charlesh97/hab/docs/superpowers/specs/dashboard.html

# ⦿ HAB-1 STRATOS

ID: #521514 COORDS: 39.3187°N / -120.3289°W

expand_less ASCENT

NOMINAL

GPS LOCK

Last pkt: 1.2s

T+03:14:22

hexagon

menu_open

LIVE MAP v2.4-STABLE

39.3187°N -120.3289°W | Alt: 18,342m

POSITION DATA

SATS

14 3D FIX

HDOP / VDOP

0.82 / 1.34

AGL (ALTITUDE)

17,210m

MOTION

GROUND SPEED 13.8 m/s

VERT SPEED 5.4 ▲ m/s

HEADING 72.6°

COURSE 74.1°

ENVIRONMENT

EXT TEMP

-42.6°C

PRESSURE

72.8 hPa

INT TEMP

12.4°C

HUMIDITY

4.2%

videocam_off NO VIDEO SIGNAL

LIVE

2.4 Mbps 98%

rtsp://192.168.1.100/stream1

RECONNECT

RF LINK STATUS

TLM

PKT

VID

FREQ

915 MHz

SNR

12.3 dB

POWER SYSTEMS

7.62V 0.84A

68%

3.3V: 3.29V

5.0V: 5.01V

12V: 11.9V

SYSTEM ALERTS

No active alerts...

Last packet: 1.2s ago

Link margin: 11 dB

PACKET RATE

2.4 pkt/s

SEQUENCE

#18430

PACKET STREAM RX: 2.4 PKT/S | SEQ: 18430

pause PAUSE delete CLEAR

04:22:31 POS lat: 39.31874, lon: -120.32891, alt_m: 18342.1, sats: 14, fix: 3

04:22:31 MOT gx: 0.02, gy: -0.01, gz: 9.81, ax: 0.1, ay: 0.2, az: -0.1, head: 72.6

04:22:30 ENV temp_ext: -42.61, temp_int: 12.42, press: 72.84, hum: 4.2, baro_alt: 18190

04:22:30 PWR v_batt: 7.62, i_batt: 0.84, p_batt: 6.4, soc: 68

04:22:29 POS lat: 39.31872, lon: -120.32890, alt_m: 18338.5, sats: 14, fix: 3

04:22:29 MOT gx: 0.01, gy: 0.00, gz: 9.79, ax: 0.2, ay: 0.1, az: -0.2, head: 72.5

04:22:28 POS lat: 39.31870, lon: -120.32888, alt_m: 18335.2, sats: 13, fix: 3

04:22:28 SYS RF link degradation detected. SNR dropped to 9.2dB temporarily.

04:22:27 POS lat: 39.31868, lon: -120.32886, alt_m: 18332.0, sats: 13, fix: 3

04:22:27 ENV temp_ext: -42.58, temp_int: 12.40, press: 72.91, hum: 4.1, baro_alt: 18182

FLIGHT OPERATIONS SYSTEM v4.2 SYSTEM HEALTH: NOMINAL UPTIME: 03:14:22

HAB-1

menu_open

⦿ HAB-1 STRATOS

ID: #521514 location_on 45.4215° N, 75.6972° W

● PHASE: ASCENT

NOMINAL

gps_fixed T+03:14:22

notifications settings

# SETTINGS

close

## ═══════ TAB 1: DEVICE ═══════

### Device Discovery

RESCAN

memory

HackRF One [0000000000000000a6e060dc264e6746]

USB BUS 001 ADDR 004

CONNECT

memory

RTLSDR-V3 [Generic 2832U]

USB BUS 001 ADDR 005

BUSY

### Connected Device

CENTER FREQUENCY

915.000 MHz

SAMPLE RATE

2.000 Msps

LNA GAIN

16 dB

VGA GAIN

24 dB

DISCONNECT DEVICE

## ═══════ TAB 2: RF PARAMETERS ═══════

FREQUENCY (MHz)

SYMBOL RATE (Msps)

LO OFFSET (PPM)

LNA GAIN (0-40 dB) 16 dB

VGA GAIN (0-62 dB) 24 dB

AMP ENABLE

DISABLED ENABLED

RESET APPLY PARAMETERS

## ═══════ TAB 3: DVB-S2 ═══════

MODCOD

PILOTS

ROLLOFF

FEC FRAME

SPS

DEVICE ARGUMENTS (ADVANCED)

RRC DELAY 10 taps

SINK TYPE TCP SERVER :5000

## ═══════ TAB 4: PIPELINE ═══════

/opt/stratos/capture/telemetry_915mhz.ts BROWSE

play_arrow START PIPELINE stop STOP

BITRATE

965,326 bps

DURATION

00:47:32

DROP RATIO

0.02%

SINK HEALTH

ACTIVE

FFMPEG_STREAM_OUT

[h264 @ 0x559e86c] frame=1240 fps=30 q=28.0 size=450kB time=00:00:41.33 bitrate=89.2kbits/s speed=1x
[h264 @ 0x559e86c] frame=1270 fps=30 q=28.0 size=482kB time=00:00:42.33 bitrate=93.4kbits/s speed=1x
[h264 @ 0x559e86c] frame=1300 fps=30 q=29.0 size=512kB time=00:00:43.33 bitrate=96.7kbits/s speed=1x

TSP_PACKET_PROCESSOR

* tsp: PID 0x0100 (SDT) pkt: 4,502, rate: 1,200 b/s
* tsp: PID 0x1FFF (Null) pkt: 1,204,502, rate: 45,600 b/s
* tsp: PID 0x0010 (NIT) pkt: 890, rate: 200 b/s

## ═══════ TAB 5: ABOUT ═══════

### System Status

SYSTEM UPTIME 72h 14m 05s

WEBSOCKET STATUS CONNECTED

CORE LOAD 12.4%

DISK USAGE (CAPTURE) 244 GB / 1024 GB

### Software Build

STRATOS v0.5-dev

HASH: 7a8c3d1f_main_stable

BUILD: 2023-11-20T14:42:00Z

CHECK FOR UPDATES

list_alt EVENT LOG

[14:42:01] HackRF One #...67464 connected. [14:42:05] Sink stream initialized on :5000 [14:42:10] Adjusting LNA Gain to +16dB (Auto)

terminal PACKET STREAM

PAUSE CLEAR EXPORT CSV

[14:42:12.4] 0x00FF2A01 FF 00 FF AA 32 1C 44 91 00 22 AB 99 FD 01 00 00 44 EF ...

[14:42:12.5] 0x00FF2A02 FF 00 FF AA 32 1C 44 91 00 22 AB 99 FD 01 00 00 45 FF ...

[14:42:12.6] 0x00FF2A03 FF 00 FF AA 32 1C 44 91 00 22 AB 99 FD 01 00 00 46 A1 ...

[14:42:12.7] 0x00FF2A04 FF 00 FF AA 32 1C 44 91 00 22 AB 99 FD 01 00 00 47 B2 ...

[14:42:12.8] 0x00FF2A05 FF 00 FF AA 32 1C 44 91 00 22 AB 99 FD 01 00 00 48 C3 ...

[14:42:12.9] 0x00FF2A06 FF 00 FF AA 32 1C 44 91 00 22 AB 99 FD 01 00 00 49 D4 ...

[14:42:13.0] 0x00FF2A07 FF 00 FF AA 32 1C 44 91 00 22 AB 99 FD 01 00 00 50 E5 ...

FLIGHT OPERATIONS SYSTEM v4.2

TELEMETRY LOG SYSTEM HEALTH MANUAL OVERRIDE
