charlesh97/hab/.superpowers/brainstorm/64589-1780717157/content/layout-proposal.html

## Proposed Layout: Map-Left / Video-Center / Data-Right

All data cards consolidated on the right — is this the direction you're thinking?

Current Layout (scattered cards)

Map

[Leaflet]

Position

Lat/Lon/Alt/Sats

Motion

GS/VS/Heading/Yaw

Environment

Temp/Pres/Humidity

Camera Feed

No video

RF Link

TEL/PKT/VID status

Power

Battery/Voltage

Alerts

Packet Rate

Proposed: Map | Video | Data Cards

HAB-1 STRATOS NOMINAL | T+03:45:12

Live Map

Leaflet Map
+ balloon track

Video Feed

Stream / Placeholder

Navigation

ALT 24,348m

GS 9.4m/s

VS +4.2m/s

HDG 045°

LAT 34.1234°N

LON 118.5678°W

SATS 11

HDOP 1.2

Environment

EXT -52.3°C

INT +22.1°C

PRESS 68.5hPa

HUM 12%

Power & Link

BAT 88.5% 12.1V / 0.8A

TEL PKT VID 12.4pkt/s

Attitude

ROLL 2.3°

PITCH -1.5°

YAW 045°

> Packet Stream

[14:10:23] POS lat=34.1234 lon=-118.5678 alt=24348 sats=11

[14:10:22] ENV ext=-52.3 int=22.1 pres=68.5 hum=12

### Right column: grouping approach

How should the consolidated data cards be organized on the right?

A

### Grouped by category (shown above)

Navigation, Environment, Power & Link, Attitude — each gets its own card

B

### Single unified telemetry card

One tall card with labeled sections — Navigation, Environment, Power, Attitude
