charlesh97/hab/docs/analysis/nmea.md

# Exhaustive Line-by-Line Analysis of `nmea.py`

**File:** `payload/gps/nmea.py` (180 lines)
**Context:** HAB (High-Altitude Balloon) packet radio — GPS-to-BPSK pipeline
**Hardware:** Quectel L76K GNSS module → Radxa Rock 2A UART0 (pins 8/10) at 9600 baud 8N1
**Used by:** `payload/tx/gps_packet_tx.py` (main TX loop), `payload/tests/test_gps.py` (Phase 1D validation)

---

## Table of Contents

1. [Module Docstring & Imports (Lines 1–6)](#1-module-docstring--imports-lines-16)
2. [Module-Level Constants (Lines 8–9)](#2-module-level-constants-lines-89)
3. [`nmea_checksum_ok()` — Checksum Validation (Lines 12–31)](#3-nmea_checksum_ok--checksum-validation-lines-1231)
4. [`_safe_float()` — Robust Float Parsing (Lines 34–40)](#4-_safe_float--robust-float-parsing-lines-3440)
5. [`_nmea_dm_to_dd()` — Coordinate Conversion (Lines 43–68)](#5-_nmea_dm_to_dd--coordinate-conversion-lines-4368)
6. [`parse_gga()` — GGA Sentence Parser (Lines 71–102)](#6-parse_gga--gga-sentence-parser-lines-71102)
7. [`parse_rmc()` — RMC Sentence Parser (Lines 105–134)](#7-parse_rmc--rmc-sentence-parser-lines-105134)
8. [`NMEAParser` Class (Lines 137–180)](#8-nmeaparser-class-lines-137180)
9. [Hardware Integration: L76K on Rock 2A](#9-hardware-integration-l76k-on-rock-2a)
10. [Usage in the Pipeline](#10-usage-in-the-pipeline)
11. [Error Handling & Robustness Summary](#11-error-handling--robustness-summary)
12. [Design Observations & Tradeoffs](#12-design-observations--tradeoffs)

---

## 1. Module Docstring & Imports (Lines 1–6)

### Line 1
```python
"""GPS NMEA parser using a 9600-baud 8N1 serial connection."""
```
The module docstring. Concise but precise: it names the protocol (NMEA), the physical layer (serial), the bit rate (9600 baud), and the framing (8 data bits, No parity, 1 stop bit — 8N1). This is not aspirational — it's the exact configuration the L76K ships with by default.

### Line 3
```python
from __future__ import annotations
```
Enables PEP 563 / PEP 604 `X | Y` union syntax without runtime cost. Available from Python 3.7+. Placed at the top of the file after the docstring, before any other imports, as required. This allows the module to use `str | None`, `float | None`, `dict[str, object] | None` in type hints without importing `Optional` or `Union` from `typing`.

### Line 5
```python
import serial
```
Single external dependency: `pyserial`. This is a pure-Python library that wraps OS-level serial port access (`/dev/ttyS0`, `/dev/ttyAMA0`, etc. on Linux; `COM` ports on Windows). On line 5, there is no try/except guard — the import is assumed to succeed. The TX pipeline and test scripts handle the `ImportError` at their own level. Given the target platform (Radxa Rock 2A running Armbian Debian 13), `pyserial` is installed via `apt` or `pip`.

---

## 2. Module-Level Constants (Lines 8–9)

### Line 8
```python
GPS_BAUD = 9600
```
The serial baud rate. 9600 is the L76K's factory default communication speed. This is intentionally low — GPS modules output at most a few dozen NMEA sentences per second, each under 100 bytes, so 9600 baud (~960 chars/sec) is more than sufficient. Higher baud rates (115200) are available on the L76K but would require explicit AT command configuration. 9600 baud was chosen because it's the module's power-on default — no init dance needed; just open the port.

### Line 9
```python
GPS_TIMEOUT = 1.0
```
Serial read timeout in seconds. Passed to `serial.Serial(timeout=...)`. With a 1-second timeout, `readline()` will block for at most 1 second waiting for a newline character. If no complete line arrives within that window, `readline()` returns whatever partial data has been buffered (or an empty bytes object if nothing was received at all). This is a critical design choice:

- **Too short** (e.g., 0.1s): risk of truncating valid NMEA sentences mid-stream, especially on a busy bus with GSV sentences arriving in bursts.
- **Too long** (e.g., 5s): the TX loop in `gps_packet_tx.py` runs at 1 Hz — a 5-second timeout would stall the loop and miss transmission windows if GPS data stops.
- **1.0s** is the sweet spot: it's a full GPS epoch (most modules output position fixes at 1 Hz), so if no data arrives in 1 second, something is wrong.

---

## 3. `nmea_checksum_ok()` — Checksum Validation (Lines 12–31)

### Line 12
```python
def nmea_checksum_ok(sentence: str) -> bool:
```
Module-level function (not inside the class). Takes a raw NMEA sentence string and returns `True` only if the checksum validates. The NMEA 0183 standard specifies that each sentence ends with `*HH` where `HH` is the two-character hexadecimal XOR checksum of all bytes between (but not including) `$` and `*`. The type hint `str -> bool` is simple and honest.

### Line 13
```python
    """Validate the XOR checksum of an NMEA sentence."""
```
Docstring. Brief but accurate. Does not mention the return type or edge cases — the code is self-documenting.

### Line 14–17
```python
    try:
        payload, checksum_str = sentence.split("*")
    except (AttributeError, ValueError):
        return False
```
The first computational block. `split("*")` on a string with no `*` raises `ValueError` (too few values to unpack). `AttributeError` is caught because `sentence` could theoretically be `None` (calling `.split()` on `None` raises `AttributeError`), though in practice callers don't pass `None`. Both exceptions return `False` — the sentence is considered invalid. This is a fail-closed approach: any structural anomaly means "not valid."

**`payload`** gets everything before the asterisk (e.g., `$GPGGA,123519,4807.038,N,01131.000,E,1,08,0.9,545.4,M,46.9,M,,`).
**`checksum_str`** gets everything after the asterisk (e.g., `47`). Note that `checksum_str` may include trailing whitespace or Carriage Return — that's handled at line 27.

### Line 19–20
```python
    if not payload.startswith("$"):
        return False
```
Guard: if the part before `*` doesn't start with `$`, it's not a proper NMEA sentence. This catches garbage lines, binary noise, or malformed data. Example of what fails: `GPGGA,120000,...*1A` (missing `$`).

### Lines 22–24
```python
    computed = 0
    for char in payload[1:]:
        computed ^= ord(char)
```
The core XOR checksum computation. The NMEA standard says: "The checksum is the 8-bit exclusive OR (no start or stop bits) of all characters in the sentence, including `,` delimiters, between but not including `$` and `*`."

- `computed = 0` initializes the accumulator.
- `payload[1:]` skips the leading `$` — this is crucial. Including `$` in the XOR would produce a wrong checksum.
- `ord(char)` converts each character to its ASCII byte value (0–127).
- `^=`: XOR-accumulation. `0 ^ X = X`, and each subsequent byte XORs with the running total.

For `$GPGGA,123519,...*47`:
- Payload after `$`: `GPGGA,123519,...`
- `computed = ord('G') ^ ord('P') ^ ord('G') ^ ord('G') ^ ord('A') ^ ord(',') ^ ...`

### Lines 26–29
```python
    try:
        expected = int(checksum_str.strip(), 16)
    except ValueError:
        return False
```
Parses the expected checksum from the string after `*`. `strip()` removes whitespace and trailing `\r` (carriage return, common in NMEA serial output). `int(..., 16)` parses hex: `"47"` → `0x47` (71 decimal). If `checksum_str` is not valid hex (e.g., `"ZZ"`, or empty), `ValueError` is caught and returns `False`.

### Line 31
```python
    return computed == expected
```
The final comparison. Returns `True` only if the XOR of the payload bytes matches the declared hex checksum. This is the gatekeeper: only sentences with valid checksums pass. In the HAB pipeline, a corrupted checksum means the sentence was damaged in transit over the UART connection (unlikely but possible with long wires or EMI) and the data is discarded — better to lose one fix than transmit bad coordinates.

---

## 4. `_safe_float()` — Robust Float Parsing (Lines 34–40)

### Line 34
```python
def _safe_float(value: str) -> float | None:
```
The leading underscore marks this as a module-internal helper. Takes a string (an NMEA field) and returns either a `float` or `None`. The return type `float | None` uses the PEP 604 union syntax.

### Lines 35–36
```python
    if not value or not value.strip():
        return None
```
Two-part guard:
- `not value`: catches `""` (empty string, which is falsy) and potentially `None` (though the type hint says `str`).
- `not value.strip()`: catches fields that are only whitespace, e.g., `"   "` or `"\r"`.

In NMEA, empty fields are common: for example, `$GPGGA,...*47,,,` has two adjacent commas, meaning the field between them is empty. Some receivers also output fields like `,,` for altitude when no fix is available. Return `None` for any of these cases — no attempt to parse as float.

### Lines 37–38
```python
    try:
        return float(value)
```
Attempts to parse the string as a float. Python's `float()` handles both integer-looking strings (`"08"` → `8.0`) and decimal strings (`"0.9"` → `0.9`). Strips leading/trailing whitespace automatically, but the guard above already handled blank fields.

### Lines 39–40
```python
    except ValueError:
        return None
```
Catches any non-numeric string (e.g., `"N/A"`, `"invalid"`, or corrupted binary garbage). Returns `None` — the caller must handle missing data.

---

## 5. `_nmea_dm_to_dd()` — Coordinate Conversion (Lines 43–68)

### Line 43
```python
def _nmea_dm_to_dd(raw: str, hemisphere: str) -> float | None:
```
Converts NMEA's Degrees-Minutes format (DDMM.MMMM or DDDMM.MMMM) to decimal degrees. Takes two arguments:
- `raw`: the coordinate string from the NMEA field (e.g., `"4807.038"` for 48°07.038', or `"01131.000"` for 11°31.000').
- `hemisphere`: `"N"`, `"S"`, `"E"`, or `"W"`. Determines sign.

Returns `float` (decimal degrees, rounded to 6 decimal places) or `None` on parse failure.

### Lines 45–46
```python
    if not raw or not hemisphere:
        return None
```
Guard: both arguments must be non-empty. If either is empty, the coordinate is meaningless.

### Lines 48–52
```python
    try:
        if "." in raw:
            int_part, frac_part = raw.split(".", 1)
        else:
            int_part, frac_part = raw, "0"
```
Splits the raw coordinate at the decimal point into integer and fractional parts. The `1` argument to `split` limits to one split — important if there were somehow multiple dots (though that shouldn't happen with valid NMEA). If there's no decimal point (unlikely in practice), treats the entire string as integer part and `"0"` as fractional.

Example: `"4807.038"` → `int_part="4807"`, `frac_part="038"`

The `try` wraps the entire function body — any `ValueError` or `IndexError` from any operation returns `None`.

### Lines 54–57
```python
        if len(int_part) <= 4:
            degree_length = 2
        else:
            degree_length = 3 if hemisphere in ("E", "W") else 2
```
This is the most subtly important logic in the file: determining how many digits represent degrees vs. minutes.

**Latitude (N/S):** Always 2 digits for degrees (max 90°). So `"4807.038"` → 2 degree digits + minutes.

**Longitude (E/W):** Either 2 or 3 digits (max 180°). The ambiguity arises because raw longitude can be `"01131.000"` (3 digits for 11°) or `"12045.678"` (3 digits for 120°). The heuristic:
- If `len(int_part) <= 4`: the total integer portion is short. If it's 4 digits like `"4807"`, that's 2 degree digits. If it's 5 digits like `"01131"`, that's 3 degree digits. But at this branch `len(int_part) <= 4`, so only ever 2 degree digits.
- If `len(int_part) > 4` (i.e., 5 digits like `"12045"` for 120°45'): degree_length is 3 for E/W (longitude can be up to 180°), 2 for N/S (latitude never exceeds 90°, so 5 digits would mean 2 degree digits + 3-minute integer digits for latitudes near the poles).

This logic is a simplified version of the test script's approach. It handles all valid NMEA coordinates but could theoretically misparse a 5-digit latitude if one were received (should never happen — latitudes are max ~90°, so the integer part is at most 2 digits for degrees, making the total integer part at most 4 digits: `"90"` + `"00"` = `"9000"`).

### Lines 59–61
```python
        degrees = float(int_part[:degree_length])
        minutes = float(int_part[degree_length:] + "." + frac_part)
        decimal_degrees = degrees + minutes / 60.0
```
The actual conversion:
- `int_part[:degree_length]` extracts the degree digits. For `"4807"` with `degree_length=2`: `"48"` → 48.0°.
- `int_part[degree_length:]` extracts the minute integer portion: `"07"`.
- `+ "." + frac_part` reconstructs the fractional minutes: `"07"` + `"."` + `"038"` → `"07.038"` → 7.038 minutes.
- `degrees + minutes / 60.0`: 48.0 + 7.038/60 = 48.0 + 0.1173 = 48.1173.

### Lines 63–64
```python
        if hemisphere in ("S", "W"):
            decimal_degrees = -decimal_degrees
```
Southern latitudes and western longitudes are negative. Northern latitudes and eastern longitudes are positive. This follows standard convention (WGS84).

### Line 66
```python
        return round(decimal_degrees, 6)
```
Rounds to 6 decimal places. At the equator, 0.000001° ≈ 0.111 meters. This is far more precision than the L76K's stated accuracy (2.5m CEP), so no meaningful precision is lost. Rounding also avoids floating-point display artifacts (e.g., `48.117300000000004`).

### Lines 67–68
```python
    except (ValueError, IndexError):
        return None
```
Catch-all for any parsing failure within the try block. Returns `None` — the caller (`parse_gga` or `parse_rmc`) propagates `None` to the result dict.

---

## 6. `parse_gga()` — GGA Sentence Parser (Lines 71–102)

### Line 71
```python
def parse_gga(sentence: str) -> dict[str, object] | None:
```
Module-level function. Takes a raw NMEA GGA sentence string. Returns a dictionary with parsed fields, or `None` if the sentence is invalid. The `object` type in the return annotation is a pragmatic choice — the dict contains `str`, `float`, `int`, and `None` values at runtime. Returns `None` for any sentence that is structurally invalid, has invalid checksum, is not a GGA sentence, or is missing critical fields.

### GGA Sentence Format (reference)

```
$GPGGA,123519.00,4807.038,N,01131.000,E,1,08,0.9,545.4,M,46.9,M,,*47
|      |         |         | |         | | |  |   |     | |     | |  |
0      1         2         3 4         5 6 7  8   9     10 11   12 13 14
```

| Field Index | Name | Example | Description |
|---|---|---|---|
| 0 | Talker+ID | $GPGGA | Sentence identifier |
| 1 | UTC Time | 123519.00 | HHMMSS.SS UTC |
| 2 | Latitude | 4807.038 | DDMM.MMMM |
| 3 | N/S indicator  | N | 'N' or 'S' |
| 4 | Longitude | 01131.000 | DDDMM.MMMM |
| 5 | E/W indicator  | E | 'E' or 'W' |
| 6 | Fix Quality | 1 | 0=invalid, 1=GPS fix, 2=DGPS, 6=DR |
| 7 | Satellites | 08 | Number of satellites used |
| 8 | HDOP | 0.9 | Horizontal dilution of precision |
| 9 | Altitude | 545.4 | Altitude above MSL (meters) |
| 10 | Altitude units | M | 'M' for meters |
| 11 | Geoid height | 46.9 | Height of geoid above WGS84 ellipsoid |
| 12 | Geoid units | M | 'M' for meters |
| 13 | DGPS age | (empty) | Time since last DGPS update |
| 14 | DGPS station | (empty) | DGPS reference station ID |

### Line 73
```python
    sentence = sentence.strip()
```
Strips leading and trailing whitespace (including `\r\n`). NMEA sentences from serial ports typically arrive as `$GPGGA,...*47\r\n`. The `\r\n` must be removed before checksum validation, since the checksum computation does not include `\r` or `\n`.

### Lines 74–75
```python
    if not nmea_checksum_ok(sentence):
        return None
```
Checksum validation is the first gate. If the checksum doesn't match, the sentence is discarded immediately — no parsing of fields.

### Lines 77–79
```python
    fields = sentence.split(",")
    if len(fields) < 11 or not fields[0].lstrip("$").endswith("GGA"):
        return None
```
Two checks:
1. **`len(fields) < 11`**: A valid GGA sentence has at least 11 comma-separated fields (indices 0–10). Fields 11–14 are optional. This check ensures we have enough fields to extract time, position, fix quality, satellites, HDOP, and altitude.
2. **`fields[0].lstrip("$").endswith("GGA")`**: The first field must identify as a GGA sentence. `lstrip("$")` removes the leading `$`, then `endswith("GGA")` matches any talker prefix: `GPGGA` (GPS), `GLGGA` (GLONASS), `GNGGA` (multi-constellation), `BDGGA` (BeiDou). The L76K is a multi-GNSS receiver and will output sentences with different talker IDs depending on which constellations are active.

### Lines 81–89 — Field Extraction

```python
    utc_time = fields[1]
    lat_raw = fields[2]
    lat_ns = fields[3]
    lon_raw = fields[4]
    lon_ew = fields[5]
    fix_quality = _safe_float(fields[6])
    satellites = _safe_float(fields[7])
    altitude = _safe_float(fields[9])
    hdop = _safe_float(fields[8])
```

Each field is extracted by positional index:

- **`utc_time` (field 1):** Raw UTC time string, e.g., `"123519.00"` for 12:35:19.00 UTC. Stored as-is; no parsing to datetime object.
- **`lat_raw` (field 2):** Raw latitude in DDMM.MMMM format, e.g., `"4807.038"`.
- **`lat_ns` (field 3):** Hemisphere for latitude — `"N"` or `"S"`.
- **`lon_raw` (field 4):** Raw longitude in DDDMM.MMMM format, e.g., `"01131.000"`.
- **`lon_ew` (field 5):** Hemisphere for longitude — `"E"` or `"W"`.
- **`fix_quality` (field 6):** Numeric fix quality indicator, parsed via `_safe_float`. Returns `None` if empty/invalid.
  - 0 = invalid / no fix
  - 1 = GPS fix (SPS)
  - 2 = DGPS fix
  - 4 = RTK fixed (not expected from L76K)
  - 5 = RTK float (not expected from L76K)
  - 6 = Dead reckoning (estimated)
- **`satellites` (field 7):** Number of satellites used in the position solution. `_safe_float` handles empty strings (no fix) → `None`.
- **`altitude` (field 9):** Altitude above Mean Sea Level in meters. Note: field 8 (HDOP) is extracted *after* field 9 — this is intentional: the order in the assignment doesn't matter since each is independent.
- **`hdop` (field 8):** Horizontal Dilution of Precision. A dimensionless number; lower is better. `<1.0` is excellent, `1-2` is good, `>5` is poor. hdop is extracted from field 8 (sandwiched between satellites and altitude) and parsed to `float` or `None`.

Note: altitude units (field 10, `"M"`) and geoid separation (fields 11–12) are not extracted — they're not needed for the PositionFrame.

### Lines 91–92
```python
    if not utc_time or not lat_raw or not lon_raw:
        return None
```
The three critical fields: time, latitude, and longitude. If any is empty or falsy (including `""`), the sentence is discarded. This handles the case where a GGA sentence has valid checksum but represents a "no fix" state with empty position fields. Without this guard, `_nmea_dm_to_dd` would get empty strings.

### Lines 94–102 — Return Dict Construction
```python
    return {
        "time": utc_time,
        "lat": _nmea_dm_to_dd(lat_raw, lat_ns),
        "lon": _nmea_dm_to_dd(lon_raw, lon_ew),
        "fix_quality": int(fix_quality) if fix_quality is not None else None,
        "altitude": altitude,
        "satellites": int(satellites) if satellites is not None else None,
        "hdop": hdop,
    }
```

Key field mappings:

| Dict Key | Source | Notes |
|---|---|---|
| `"time"` | `utc_time` | Raw string, e.g., `"123519.00"`. Not parsed to structured time. |
| `"lat"` | `_nmea_dm_to_dd(lat_raw, lat_ns)` | Decimal degrees, e.g., `48.1173`. `None` if conversion fails. |
| `"lon"` | `_nmea_dm_to_dd(lon_raw, lon_ew)` | Decimal degrees, e.g., `11.516667`. `None` if conversion fails. |
| `"fix_quality"`| `fix_quality` | Converted to `int` (e.g., `float(1.0)` → `int(1)`). `None` if unparseable. |
| `"altitude"` | `altitude` | `float` meters MSL or `None`. |
| `"satellites"` | `satellites`  | Converted to `int`. `None` if unparseable. |
| `"hdop"` | `hdop` | `float` or `None`. |

The `int(fix_quality) if fix_quality is not None else None` pattern ensures that values like `1.0` (parsed by `_safe_float` which returns `float`) become `int` `1` rather than `1.0`. Similarly for `satellites`. This matters for downstream consumers (`gps_packet_tx.py` line 172: `int(fq) if fq is not None else 0`) which expect integer values.

**Important:** The `"altitude"` field is stored as a raw `float` — no `int()` conversion because altitude can legitimately have fractional meters (`545.4`). The TX pipeline assigns this directly to `PositionFrame.alt_m` (a float field).

---

## 7. `parse_rmc()` — RMC Sentence Parser (Lines 105–134)

### Line 105
```python
def parse_rmc(sentence: str) -> dict[str, object] | None:
```
Module-level function for parsing RMC (Recommended Minimum Navigation Information) sentences. RMC provides time, date, position, speed over ground, and track angle. While not currently used in the main TX pipeline (which only calls `parse_gga`), it's included for completeness and is exercised in the test script.

### RMC Sentence Format (reference)

```
$GPRMC,123519,A,4807.038,N,01131.000,E,022.4,084.4,230394,003.1,W*6A
|      |       | |         | |         | |     |     |      |     |
0      1       2 3         4 5         6 7     8     9      10    11
```

| Field Index | Name | Example | Description |
|---|---|---|---|
| 0 | Talker+ID | $GPRMC | Sentence identifier |
| 1 | UTC Time | 123519 | HHMMSS UTC |
| 2 | Status | A | 'A'=valid, 'V'=warning |
| 3 | Latitude | 4807.038 | DDMM.MMMM |
| 4 | N/S indicator  | N | 'N' or 'S' |
| 5 | Longitude | 01131.000 | DDDMM.MMMM |
| 6 | E/W indicator  | E | 'E' or 'W' |
| 7 | Speed (knots)  | 022.4 | Speed over ground |
| 8 | Track angle | 084.4 | Course over ground, degrees true |
| 9 | Date | 230394 | DDMMYY |
| 10 | Mag variation  | 003.1 | Magnetic variation, degrees |
| 11 | Var direction  | W | 'E' or 'W' |

### Lines 107–109
```python
    sentence = sentence.strip()
    if not nmea_checksum_ok(sentence):
        return None
```
Same pattern as `parse_gga`: strip whitespace, validate checksum first.

### Lines 111–113
```python
    fields = sentence.split(",")
    if len(fields) < 10 or not fields[0].lstrip("$").endswith("RMC"):
        return None
```
Minimum 10 fields for RMC (indices 0–9). Matches any talker prefix ending with `RMC`: `GPRMC`, `GLRMC`, `GNRMC`.
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
