charlesh97/hab/soak/2026-07-31_163520/stills/still_0013.jpg

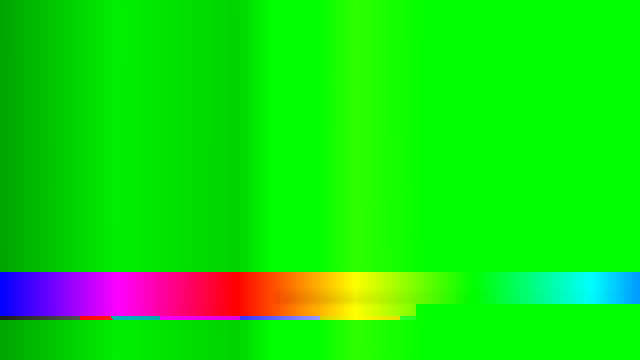
soak/2026-07-31_163520/stills/still_0013.jpg
