charlesh97/hab/hardware/105mmHeater.dxf

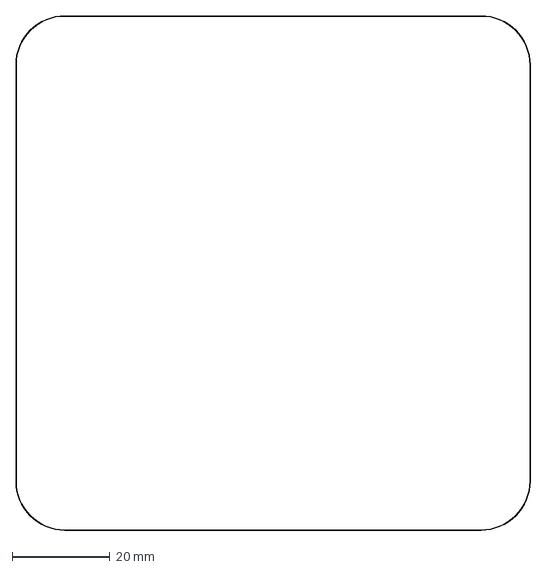
[picture p10: CAD file, 2025-11-26]
hardware/105mmHeater.dxf
105.0 x 105.0 mm
