charlesh97/hab/hardware/hab-devboard/Keepout.dxf

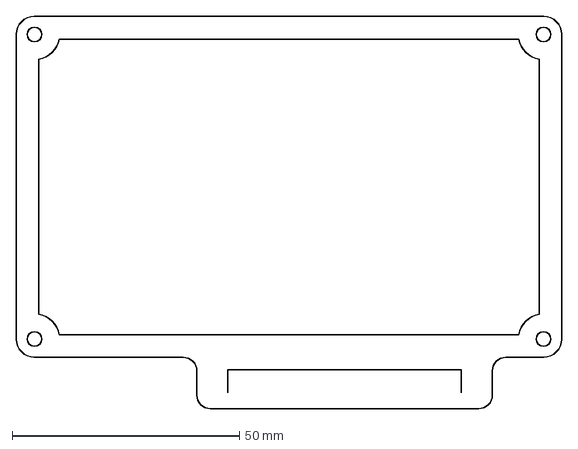
[picture p11: CAD file, 2025-11-16]
hardware/hab-devboard/Keepout.dxf
120.0 x 86.3 mm
