charlesh97/hab/hardware/temperature/output/temperature.step

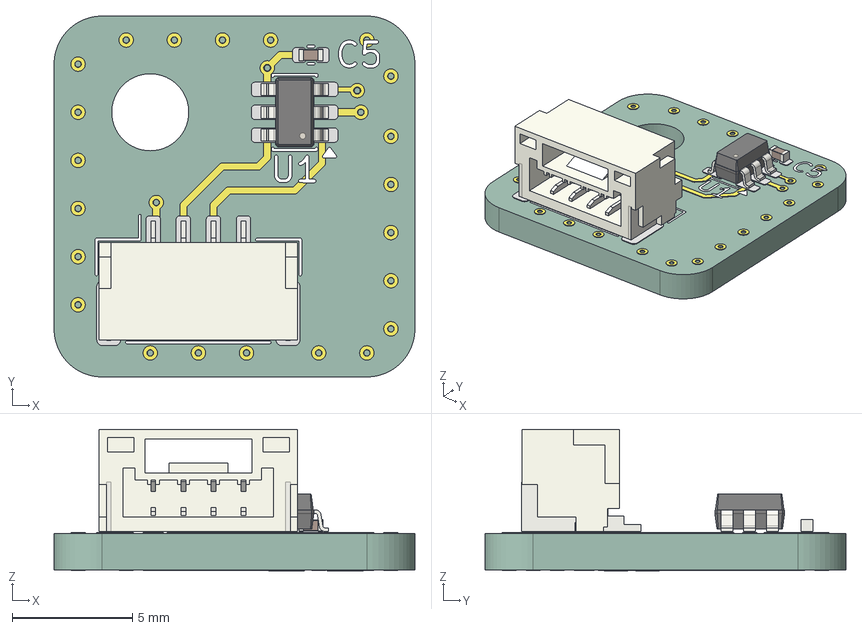
[picture p12: CAD file, 2025-11-26]
hardware/temperature/output/temperature.step
15.0 x 15.0 x 5.92 mm
C_0402_1005Metric
SOT-23-6
JST_GH_SM04B-GHS-TB_1x04-1MP_P1.25mm_Horizontal
temperature_copper
temperature_pad
temperature_via
temperature_silkscreen x 2
temperature_PCB
