charlesh97/hab/hardware/Power_Amplifier.dxf

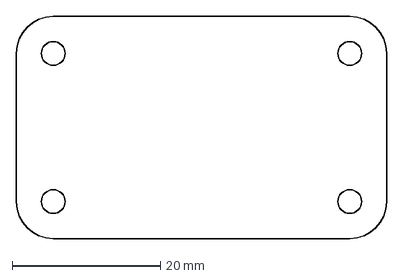
[picture p13: CAD file, 2025-11-16]
hardware/Power_Amplifier.dxf
50.0 x 30.0 mm
