charlesh97/hab/hardware/hab-devboard/output/devboard.pdf

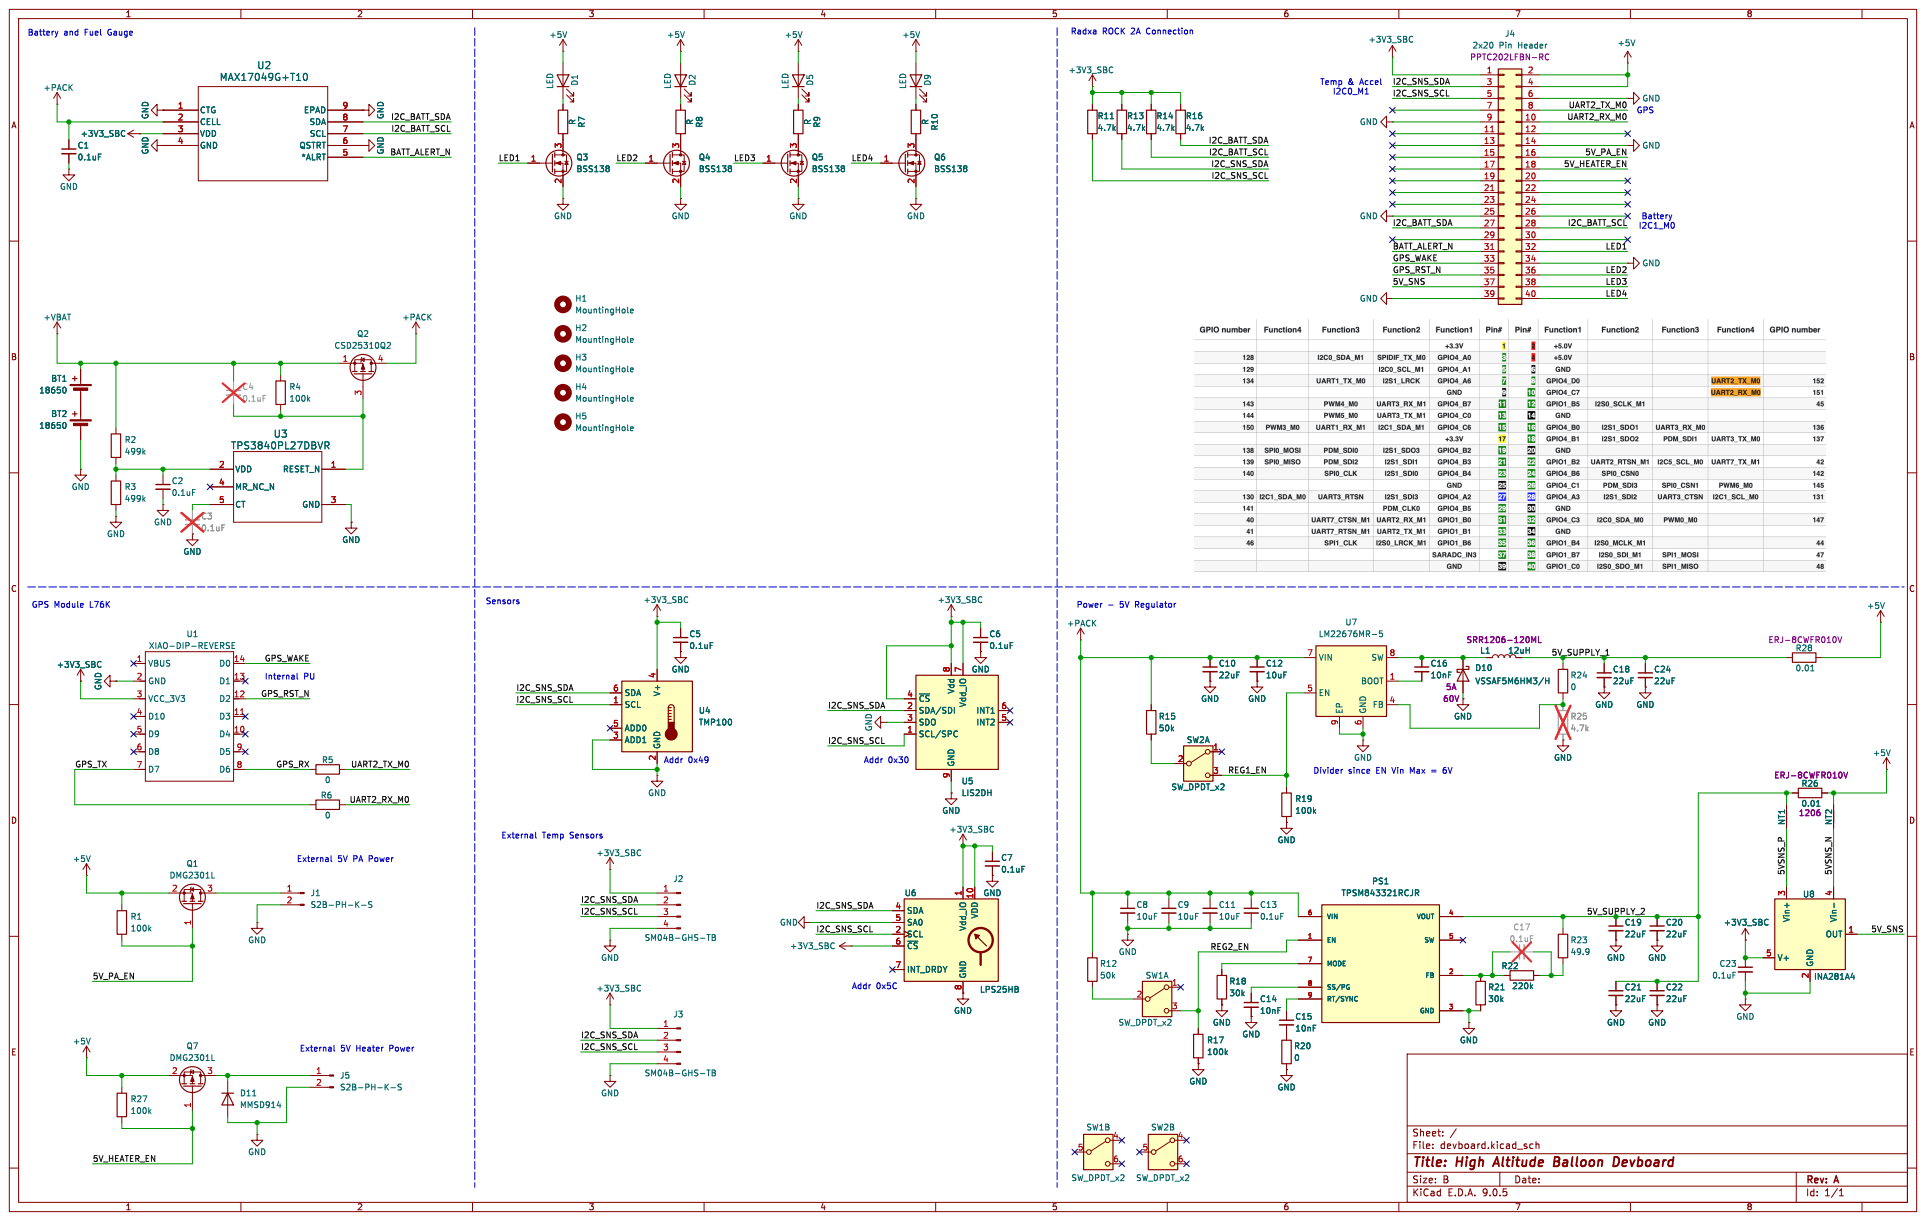
[picture p14: page 1]

H5 MountingHole H1 MountingHole H3 MountingHole H4 MountingHole +PACK

Id: 1/1 Title: High Altitude Balloon Devboard
