charlesh97/hab/hardware/temperature/temperature.kicad_pcb

## KiCad design hardware/temperature/temperature.kicad_pcb (2025-11-26)

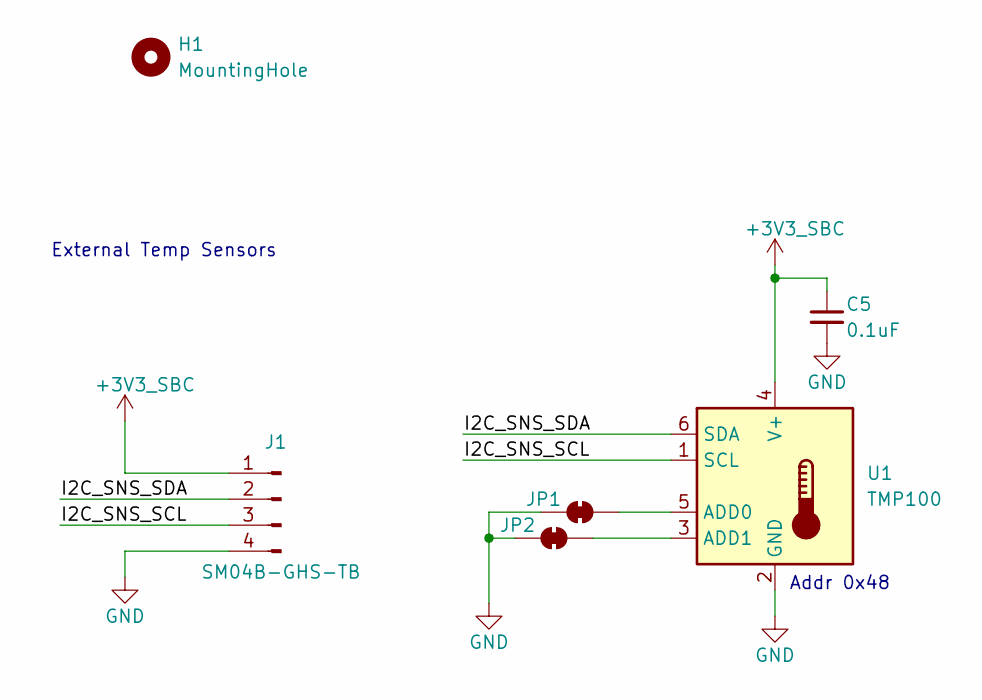
[picture p15: schematic temperature.kicad_sch]

Parts:
C5: 0.1uF; C_0402_1005Metric
H1: MountingHole; MountingHole_3.2mm_M3
J1: SM04B-GHS-TB; JST_GH_SM04B-GHS-TB_1x04-1MP_P1.25mm_Horizontal
JP1, JP2: SolderJumper_2_Bridged; SolderJumper-2_P1.3mm_Bridged_RoundedPad1.0x1.5mm
U1: TMP100; SOT-23-6

Connections:
+3V3_SBC: C5.1, J1.1, U1.4 (V+)
/I2C_SNS_SCL: J1.3, U1.1 (SCL)
/I2C_SNS_SDA: J1.2, U1.6 (SDA)
GND: C5.2, J1.4, JP1.1 (A), JP2.1 (A), U1.2 (GND)
unnamed: JP1.2 (B), U1.5 (ADD0)
unnamed: JP2.2 (B), U1.3 (ADD1)

Notes on the sheet:
Addr 0x48
External Temp Sensors

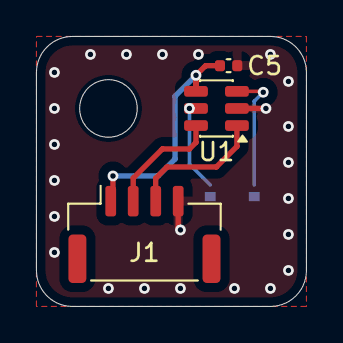
[picture p16: board temperature.kicad_pcb from above]

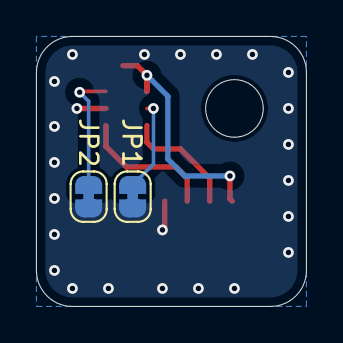
[picture p17: board temperature.kicad_pcb from below]

Board: 2 copper layers, 15.0 x 15.0 mm, 6 parts (2 on the bottom side), 6 nets.
