charlesh97/hab/hardware/hab-devboard/devboard.kicad_pcb

## KiCad design hardware/hab-devboard/devboard.kicad_pcb (2025-11-26)

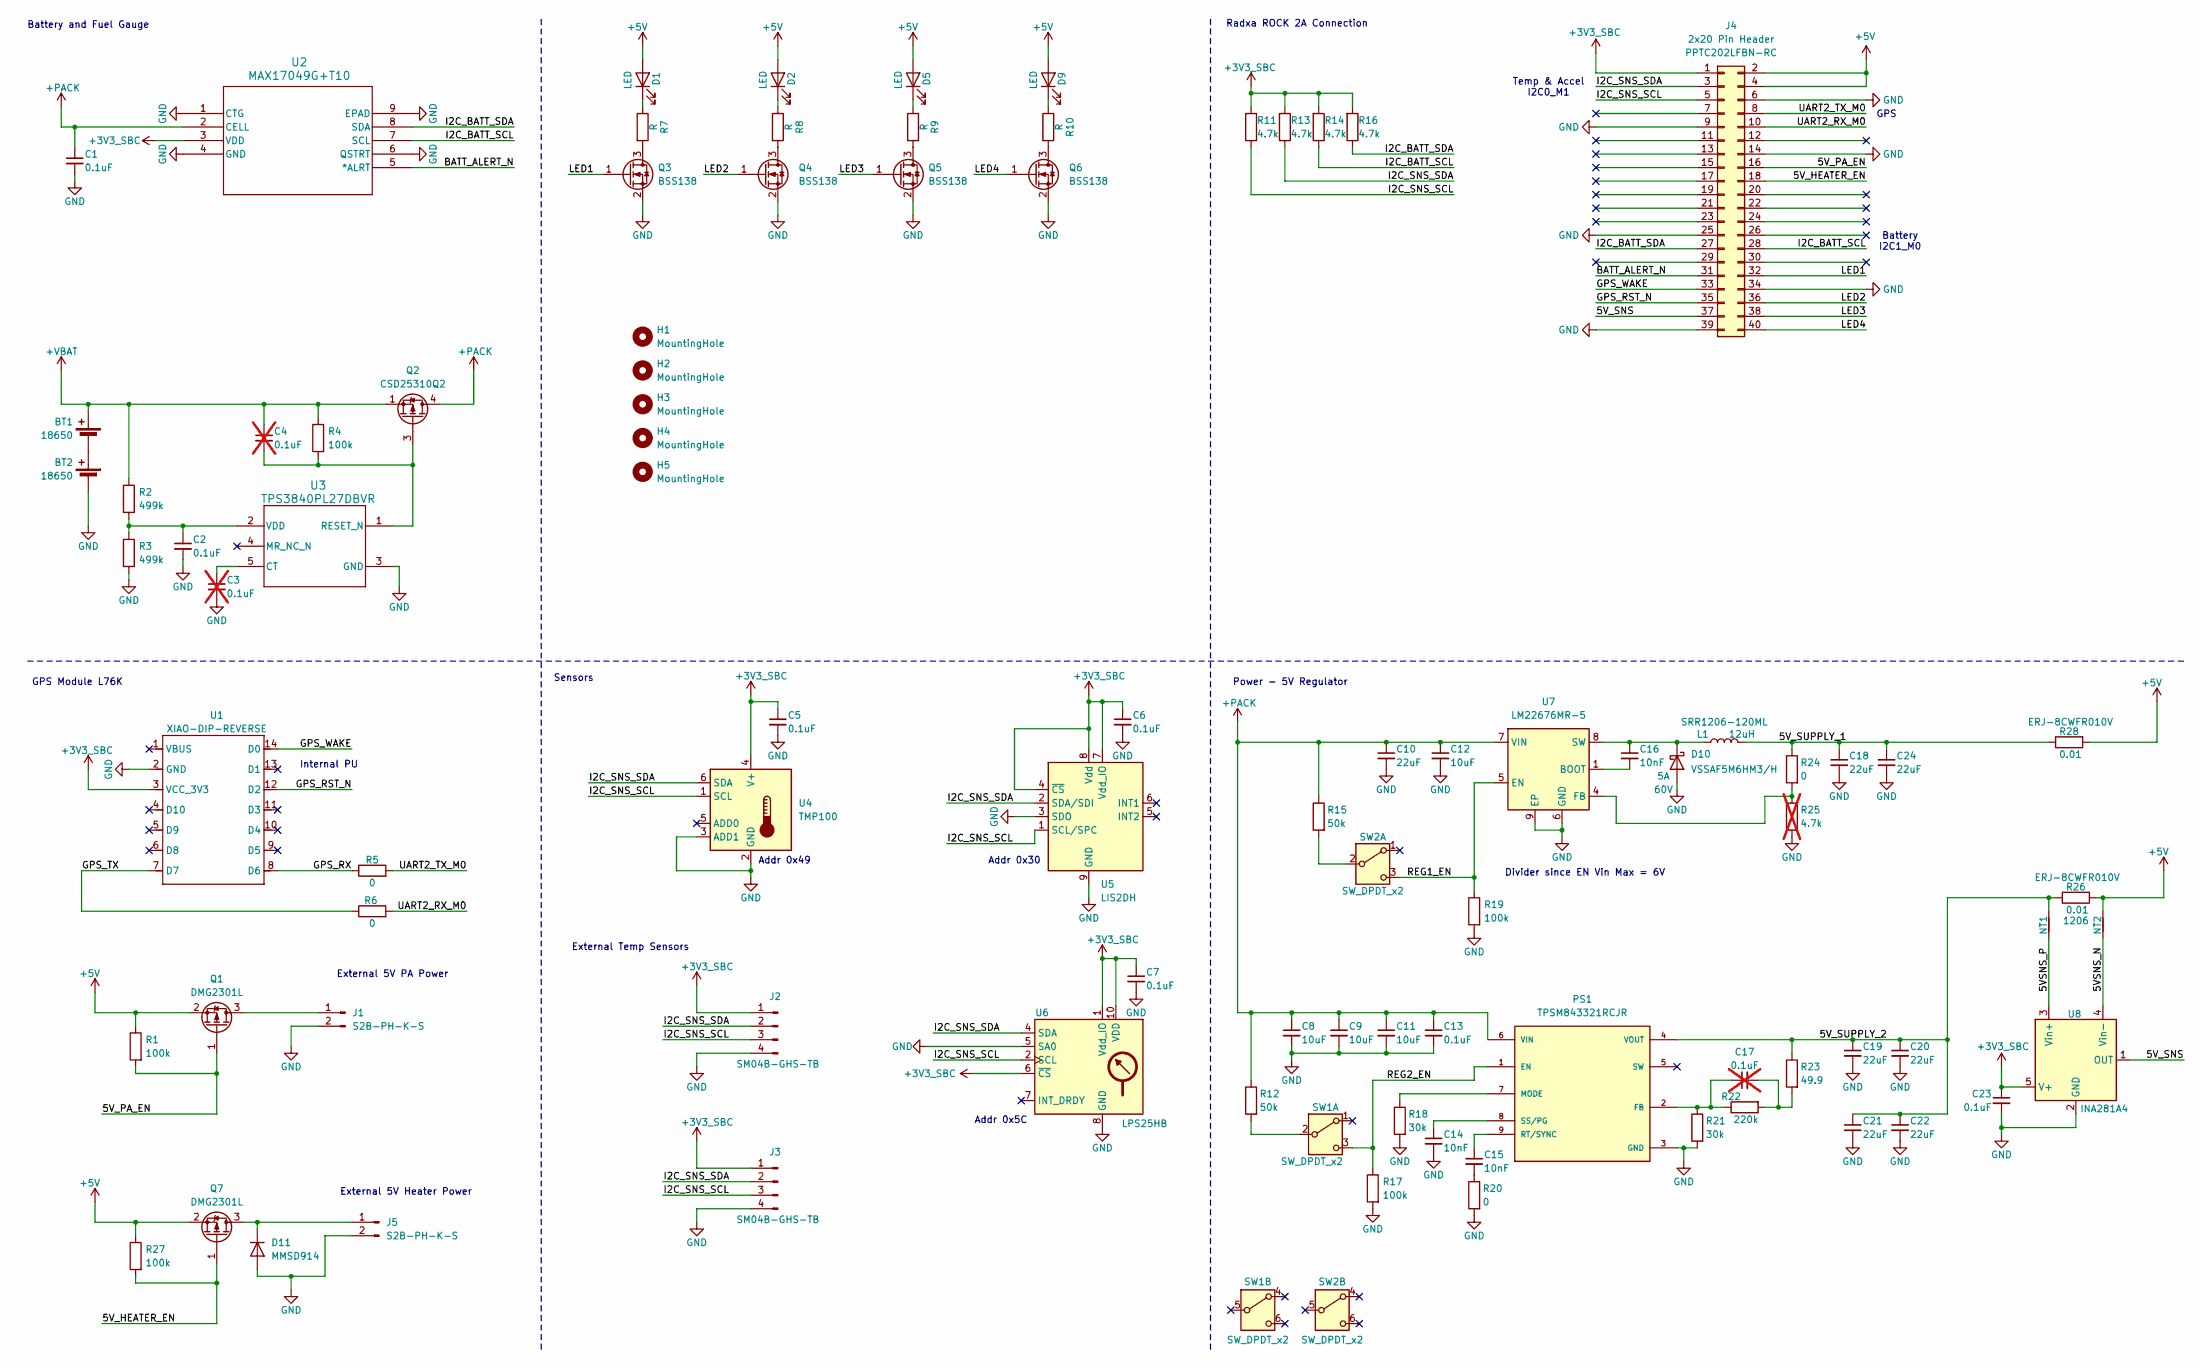
[picture p18: schematic devboard.kicad_sch, High Altitude Balloon Devboard]

Parts:
BT1, BT2: 18650; KEYSTONE_54_18650
C1, C2, C5, C6, C7, C13, C23: 0.1uF; C_0402_1005Metric
C3, C4, C17: 0.1uF; C_0402_1005Metric; not fitted
C8, C9, C11, C12: 10uF; C_0805_2012Metric
C10, C18, C19, C20, C21, C22, C24: 22uF; C_1206_3216Metric
C14, C15, C16: 10nF; C_0402_1005Metric
D1, D2, D5, D9: LED; LED_0805_2012Metric
D10: VSSAF5M6HM3/H; VISHAY_DO_221AC; Voltage 60V
D11: MMSD914; D_SOD-123
H1, H2, H3, H4, H5: MountingHole; MountingHole_3.2mm_M3
J1, J5: S2B-PH-K-S; JST_PH_S2B-PH-K_1x02_P2.00mm_Horizontal
J2, J3: SM04B-GHS-TB; JST_GH_SM04B-GHS-TB_1x04-1MP_P1.25mm_Horizontal
J4: 2x20 Pin Header; PinSocket_2x20_P2.54mm_Vertical; Part Number PPTC202LFBN-RC
L1: 12uH; IND_BOURNS_SRR1206; Part Number SRR1206-120ML
NT1, NT2: NetTie_2; NetTie-2_SMD_Pad0.5mm
PS1: TPSM843321RCJR; MODULE_TPSM843321RCJR; PARTREV March 2025
Q1, Q7: DMG2301L; SOT-23
Q2: CSD25310Q2; Texas_DQK
Q3, Q4, Q5, Q6: BSS138; SOT-23
R1, R4, R17, R19, R27: 100k; R_0603_1608Metric
R2, R3: 499k; R_0603_1608Metric
R5, R6, R20, R24: 0; R_0603_1608Metric
R7, R8, R9, R10: R; R_0603_1608Metric
R11, R13, R14, R16: 4.7k; R_0603_1608Metric
R12, R15: 50k; R_0603_1608Metric
R18, R21: 30k; R_0603_1608Metric
R22: 220k; R_0603_1608Metric
R23: 49.9; R_0603_1608Metric
R25: 4.7k; R_0603_1608Metric; not fitted
R26, R28: 0.01; R_1206_3216Metric; Part Number ERJ-8CWFR010V
SW1, SW2: SW_DPDT_x2; SW_DPDT_CK_JS202011JCQN
U1: XIAO-DIP-REVERSE; XIAO-DIP-SMT
U2: MAX17049G+T10; MAX17048_DFN
U3: TPS3840PL27DBVR; SOT-23-5
U4: TMP100; SOT-23-6
U5: LIS2DH; LGA-14_2x2mm_P0.35mm_LayoutBorder3x4y
U6: LPS25HB; ST_HLGA-10_2.5x2.5mm_P0.6mm_LayoutBorder3x2y
U7: LM22676MR-5; TI_SO-PowerPAD-8
U8: INA281A4; SOT-23-5

Connections:
+3V3_SBC: C5.1, C6.1, C7.1, C23.1, J2.1, J3.1, J4.1, R11.2, R13.2, R14.2, R16.2, U1.3 (VCC_3V3), U2.3 (VDD), U4.4 (V+), U5.4 (~CS), U5.7 (Vdd_IO), U5.8 (Vdd), U6.1 (Vdd_IO), U6.6 (~CS), U6.10 (VDD), U8.5 (V+)
+5V: D1.2 (A), D2.2 (A), D5.2 (A), D9.2 (A), J4.2, J4.4, NT2.2, Q1.2 (S), Q7.2 (S), R1.1, R26.2, R27.1, R28.2
+PACK: C1.1, C8.1, C9.1, C10.1, C11.1, C12.1, C13.1, PS1.6 (VIN), Q2.4 (D), Q2.7 (D), R12.1, R15.1, U2.2 (CELL), U7.7 (VIN)
+VBAT: BT1.1 (+), C4.1, Q2.1 (S), Q2.2 (S), Q2.5 (S), Q2.6 (S), Q2.8 (S), R2.1, R4.1
/5VSNS_N: NT2.1, U8.4 (Vin-)
/5VSNS_P: NT1.1, U8.3 (Vin+)
/5V_HEATER_EN: J4.18, Q7.1 (G), R27.2
/5V_PA_EN: J4.16, Q1.1 (G), R1.2
/5V_SNS: J4.37, U8.1 (OUT)
/5V_SUPPLY_1: C18.1, C24.1, L1.2, R24.1, R28.1
/5V_SUPPLY_2: C19.1, C20.1, C21.1, C22.1, NT1.2, PS1.4 (VOUT), R23.1, R26.1
/BATT_ALERT_N: J4.31, U2.5 (*ALRT)
/GPS_RST_N: J4.35, U1.12 (D2)
/GPS_RX: R5.1, U1.8 (D6)
/GPS_TX: R6.1, U1.7 (D7)
/GPS_WAKE: J4.33, U1.14 (D0)
/I2C_BATT_SCL: J4.28, R14.1, U2.7 (SCL)
/I2C_BATT_SDA: J4.27, R16.1, U2.8 (SDA)
/I2C_SNS_SCL: J2.3, J3.3, J4.5, R11.1, U4.1 (SCL), U5.1 (SCL/SPC), U6.2 (SCL)
/I2C_SNS_SDA: J2.2, J3.2, J4.3, R13.1, U4.6 (SDA), U5.2 (SDA/SDI), U6.4 (SDA)
/LED1: J4.32, Q3.1 (G)
/LED2: J4.36, Q4.1 (G)
/LED3: J4.38, Q5.1 (G)
/LED4: J4.40, Q6.1 (G)
/REG1_EN: R19.1, SW2.3 (C), U7.5 (EN)
/REG2_EN: PS1.1 (EN), R17.1, SW1.3 (C)
/UART2_RX_M0: J4.10, R6.2
/UART2_TX_M0: J4.8, R5.2
GND: BT2.2 (-), C1.2, C2.2, C3.2, C5.2, C6.2, C7.2, C8.2, C9.2, C10.2, C11.2, C12.2, C13.2, C14.2, C18.2, C19.2, C20.2, C21.2, C22.2, C23.2, C24.2, D10.2 (A), D11.2 (A), J1.2, J2.4, J3.4, J4.6, J4.9, J4.14, J4.25, J4.34, J4.39, J5.2, PS1.3 (GND), Q3.2 (S), Q4.2 (S), Q5.2 (S), Q6.2 (S), R3.2, R17.2, R18.2, R19.2, R20.2, R21.2, R25.2, U1.2 (GND), U2.1 (CTG), U2.4 (GND), U2.6 (QSTRT), U2.9 (EPAD), U3.3 (GND), U4.2 (GND), U4.3 (ADD1), U5.3 (SDO), U5.9 (GND), U5.10 (GND), U5.11 (GND), U5.12 (GND), U5.13 (GND), U5.14 (GND), U6.3 (GND), U6.5 (SA0), U6.8 (GND), U6.9 (GND), U7.6 (GND), U7.9 (EP), U8.2 (GND)
unnamed: BT1.2 (-), BT2.1 (+)
unnamed: C15.2, R20.1
unnamed: C17.2, R22.2, R23.2
unnamed: D1.1 (K), R7.1
unnamed: D2.1 (K), R8.1
unnamed: D5.1 (K), R9.1
unnamed: D9.1 (K), R10.1
unnamed: C16.1, D10.1 (K), L1.1, U7.8 (SW)
unnamed: D11.1 (K), J5.1, Q7.3 (D)
unnamed: J1.1, Q1.3 (D)
unnamed: C17.1, PS1.2 (FB), R21.1, R22.1
unnamed: PS1.7 (MODE), R18.1
unnamed: C15.1, PS1.9 (RT/SYNC)
unnamed: C14.1, PS1.8 (SS/PG)
unnamed: C4.2, Q2.3 (G), R4.2, U3.1 (RESET_N)
unnamed: Q3.3 (D), R7.2
unnamed: Q4.3 (D), R8.2
unnamed: Q5.3 (D), R9.2
unnamed: Q6.3 (D), R10.2
unnamed: R12.2, SW1.2 (B)
unnamed: R15.2, SW2.2 (B)
unnamed: C3.1, U3.5 (CT)
unnamed: C2.1, R2.2, R3.1, U3.2 (VDD)
unnamed: C16.2, U7.1 (BOOT)
unnamed: R24.2, R25.1, U7.4 (FB)

Notes on the sheet:
Temp & Accel I2C0_M1
Addr 0x49
Power - 5V Regulator
External 5V Heater Power
GPS
Battery and Fuel Gauge
Addr 0x5C
Addr 0x30
External 5V PA Power
External Temp Sensors
GPS Module L76K
Radxa ROCK 2A Connection
Battery I2C1_M0
Sensors
Divider since EN Vin Max = 6V
Internal PU

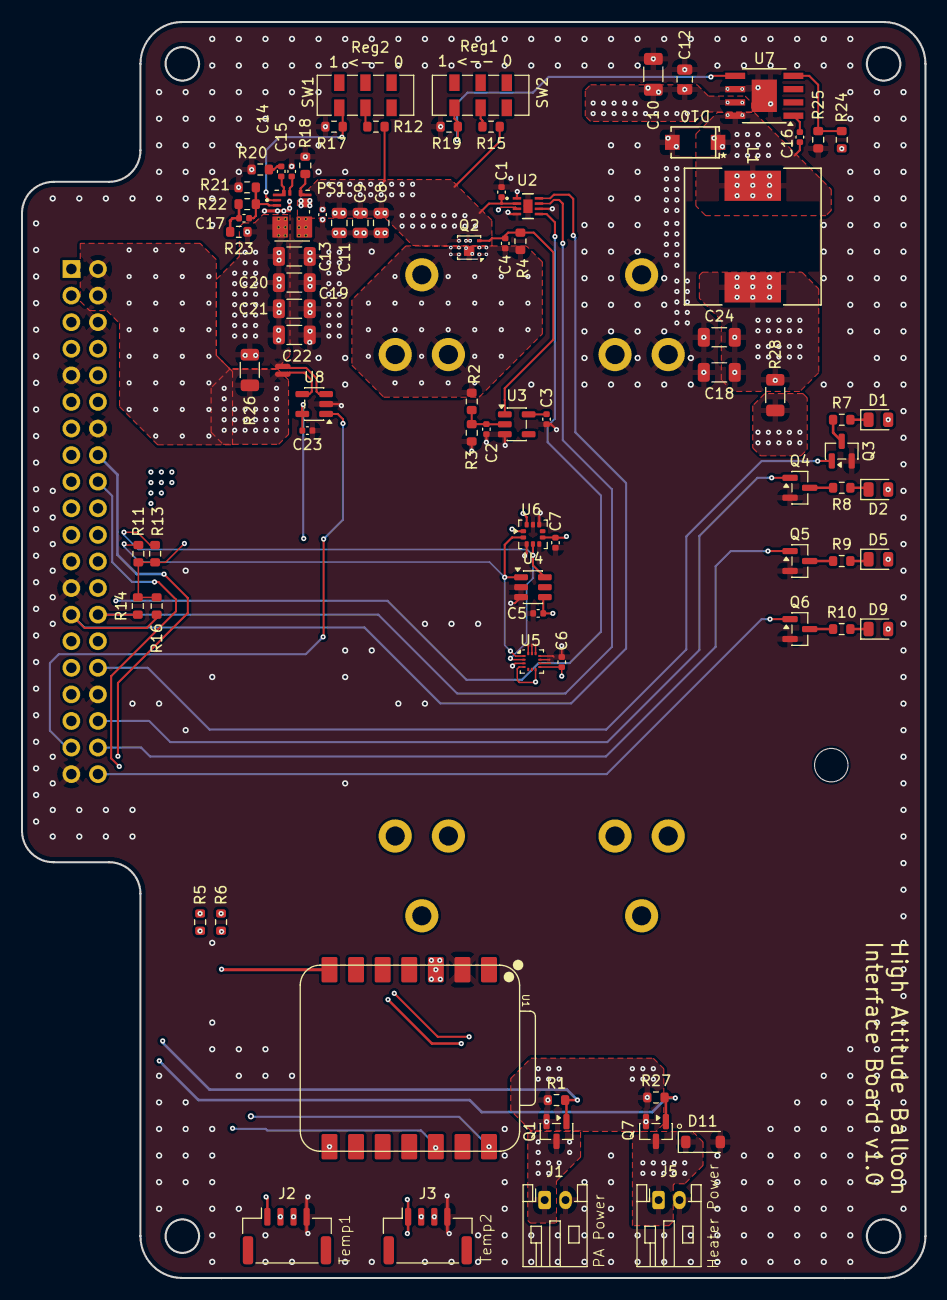
[picture p19: board devboard.kicad_pcb from above]

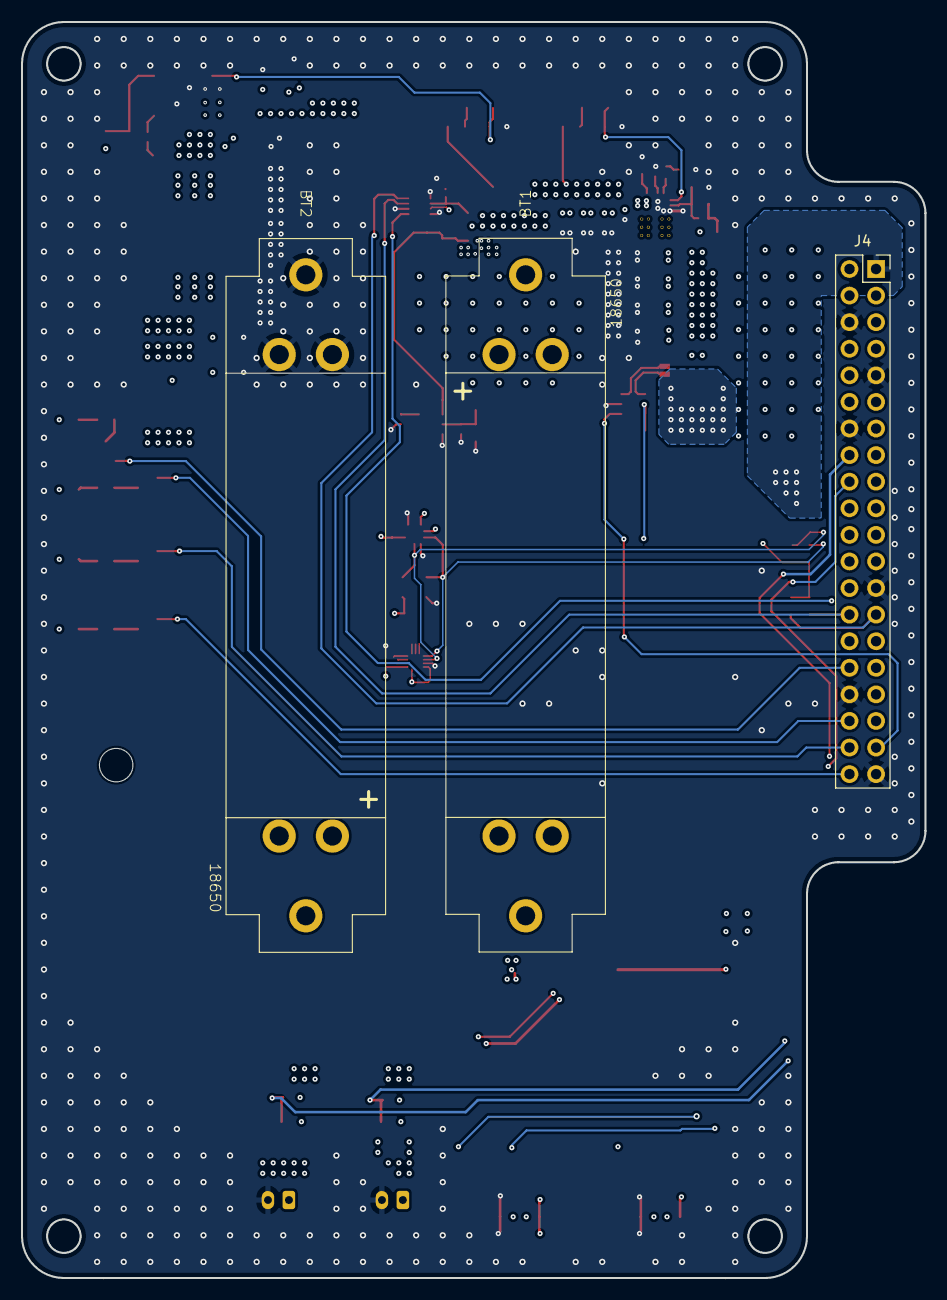
[picture p20: board devboard.kicad_pcb from below]

Board: 4 copper layers, 86.3 x 120.0 mm, 91 parts (3 on the bottom side), 54 nets.
