charlesh97/hab/(commit log)

2025-08-10 Add hab-esp32 hab-gui couple of files, in preparation for developing a wireless telemetry link for balloon
2025-11-16 pcb updates, created temperature board, finished devboard
    [Keepout.dxf, Power_Amplifier.dxf, devboard.kicad_pcb, devboard.kicad_sch, rf_pa_se2576l.kicad_pcb, rf_pa_se2576l.kicad_sch, temperature.kicad_pcb, temperature.kicad_sch]
2025-11-24 Updating pcb, adding xcode project for macOS gui
    [devboard.kicad_pcb, devboard.kicad_sch]
2025-11-26 major overhaul for rflink. Python scripts for gr-dvbs rx/tx. Tested in loopback mode. Have not added mpeg pipeline yet. See readme for details. Exported pcb files for fab
    [105mmHeater.dxf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]
2025-11-29 updated pcb bom, rebuild some esp32 files
    [devboard.csv, devboard_bom_v0.xlsx, devboard_mouser.csv, export.csv]
2026-05-11 feat(rf-link): BPSK packet link — HELLO WORLD TX/RX proven at 5,800+ packets/20s
    Add native Python BPSK packet transmitter and receiver that successfully
    sent and decoded 'HELLO WORLD\n' over an SMA cable between two HackRF Ones.
    Key findings during development:
    - Sync-word correlation (0xE38FC0FC) beats preamble correlation for exact
    packet boundaries — the 256-bit alternating preamble gives flat peaks
    - GNU Radio map_bb([1,-1]) wraps -1 to 255, killing BPSK. Fixed with direct
    float symbols instead of GNU Radio symbol mapper
    - SoapySDR sink requires throttle block or scheduler won't stream
    - RRC filter gain must equal sps (default 1.0 → 0.055V output)
    - FO estimation must run on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
2026-05-11 feat(rf-link): CRC-32 + FEC codec for packet payload
    Add two new modules as the foundation for Step 1 of the packet structure
    alignment (ALIGNMENT_PLAN.md):
    fec_cc.py — Convolutional code encoder + Viterbi decoder
    - k=7, rate=1/2, polys=[109, 79], CC_TERMINATED
    - Verified bit-exact against GNU Radio's fec.cc_encoder (--gr-check)
    - Uses 2-bit pre-padding to avoid the byte-alignment truncation bug
    (always byte-aligned output, no 2-bit loss on decode)
    packet_codec.py — Packet framing with CRC-32
    - packet_encode(payload): CRC-32 append + pad + FEC encode
    - packet_decode(encoded): FEC decode + unpad + CRC validate
    - Returns None on CRC mismatch (detects corruption)
    - Works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
2026-05-11 docs(rf-link): update documentation with enhanced chain
    HELLO_TX_RX.md now describes both the legacy and enhanced packet
    structures. ALIGNMENT_PLAN.md tracks progress on all 6 alignment steps.
2026-05-11 test(rf-link): formal 3-layer test suite
    Layer 1 — Direct Codec Unit Tests (ms): encode/decode round-trip for
    11 payload sizes, empty, binary, oversized, max_payload rejection,
    corruption detection, size predictions.
    Layer 2 — RF Software Loopback (seconds): full TX→RX pipeline in
    software — BPSK modulate, IQ save/load, FO scan, RRC filter,
    decimate, sync correlate, FEC decode, CRC validate. Tests single
    packets, burst, oversized capture.
    Layer 3 — Hardware Cable Test (real-time, skipped if no HackRF):
    TX → SMA cable → RX with thread-safe concurrent execution.
    Run: cd rf-link/packet/test && ./test_all.py
2026-05-13 Fix FO estimation for hardware: correlation-based scan_frequency replaces biased centroid
    - scan_frequency() now uses sync-word correlation to find FO (±20kHz sweep, 500Hz step)
    - Falls back to spectral centroid for software loopback (FO ≈ 0)
    - Fixes test_layer3.py: assigns distinct serial numbers to TX/RX HackRFs
    instead of both opening 'driver=hackrf' (device conflict)
    - Hardware proven: FO=-6500/7200Hz decodes 'HELLO HARDWARE' from captured IQ
    Offline decode verified. Layers 1+2 pass all tests. SoapySDR/GNU Radio TX
    driver needs USB reset for automated Layer 3 live test.
2026-05-17 Fix hardware decode: sync-word FO refinement + energy threshold + Layer 3 subprocess
    Root cause: Three issues prevented hardware cable loopback from decoding.
    1. AGC applied before FO estimation destroyed energy detection:
    - scan_frequency finds energy peaks, but AGC normalizes noise floor
    to the same RMS as signal, making detection impossible
    - Fix: Estimate FO on RAW samples (DC-blocked, no AGC)
    2. Energy detection threshold hardcoded at 10, but HackRF via SoapySDR
    returns CF32 float samples with max magnitude ~1.3
    - Fix: Changed to _SIGNAL_DETECT_THRESHOLD = 0.1
    3. Coarse FO estimate (±250-500 Hz resolution) caused residual phase
    rotation over 8304-symbol FEC paylo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
2026-05-17 Step 3 final: scan_frequency 4-phase fix + Codex review findings
    - scan_frequency: reduced from 20 to 4 phases (was 10x slower than
    original 2-phase version — caused ~25s per chunk, only 1 chunk
    processed per 30s run)
    - Fixed file-mode bb.real → bb (Codex finding: dropping Q channel
    would fail for recorded signals with real FO)
    - Cleaned up debug test scripts (test_hw_*.py)
    - Added tx_continuous.py for gap-free cable loopback testing
    - CODEX_REVIEW.md from code review
    Test results: Layer 1: 7/7, Layer 2: 13/13, Layer 3: 10+ packets/30s
2026-05-18 HAB Ground Station v0.1 — Full pipeline buildout
    ## Python Backend
    - Fixed dvbs2_flowgraph.py: corrected soapy_hackrf_sink_0 bug, set_freq→set_frequency, added real FFT spectrum extraction
    - Built HabEngine (singleton orchestrator): FlowgraphManager, PipelineManager, WebSocket server
    - Refactored GUI tabs (Connection, DVBS2-TX, Telemetry) to use HabEngine
    - Added Dashboard tab with live metric cards (engine, device, pipeline, TX, frequency, bitrate)
    - Created hab_engine/ package with typed data models (SpectrumFrame, PipelineStatus, EngineStatus, DeviceInfo)
    - WebSocket server on ws://localhost:8765 broadcasts spectrum + status data
    - OTA loopback verified: 96% recovery, lock at 4.7dB SN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
    [main.cpp]
2026-05-18 HAB Ground Station v0.2 — Cinematic visual refactor + WebSocket live test
    ## Visual Redesign
    - Completed rewritten QT stylesheet: #0a0a0b dark theme, glassmorphism cards, pill navigation
    - New hab_engine/widgets.py: GlassCard, MetricTile, StatusPill, NavPill, PrimaryButton, TopBar, Divider
    - Dashboard tab: MetricTile grid with status-colored values, system info panel
    - Connection tab: GlassCard sections for device discovery, RF params, log
    - DVBS2-TX tab: Split pipeline/TX controls, spectrum waterfall with orange accent
    - Telemetry tab: Clean spectrum analyzer with max-hold, styled terminal
    - Installed Inter font family for proper typography
    ## Verified Testing
    - GUI launches cleanly (no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
    [main.py]
2026-05-18 HAB Ground Station v0.3 — Web Dashboard MVP
    ## Architecture Pivot: PySide6 GUI → Web Dashboard
    - Killed macOS SwiftUI app
    - New Python aiohttp server (port 3000) serving React SPA + REST API
    - Existing HabEngine WebSocket (port 8765) provides live data stream
    - React app connects via WebSocket + HTTP API for real-time telemetry
    ## React Frontend
    - Full STRATOS dashboard: Earth background, hero telemetry card, bottom modules
    - useHabApi hook: WebSocket connection with auto-reconnect
    - LIVE connection indicator (green/red badge with ws:8765 status)
    - Components: TopBar, HeroStage, AssetCard, MissionSettingsGrid, TrajectoryCard
    - Dark cinematic theme with glassmorphism cards
    ## Server Arc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
2026-05-18 HAB Ground Station v0.3.1 — Full-web MVP feature complete
    ## Dashboard Pages
    - Overview: HeroStage (telemetry card) + Spectrum mini-widget + bottom modules (AssetCard, MissionSettingsGrid, TrajectoryCard) + StatusBar
    - Telemetry: SpectrumWaterfall (real-time FFT canvas) + TelemetryGrid (9 stat tiles) + TelemetryCharts (altitude + temp) + LowerTabs (Video Feeds / RF Config / Data Stream)
    - Map: Full-screen FlightMap (Leaflet) with balloon position, flight path, predicted trajectory overlay
    - Settings: Dark-themed RF Config panel with functional controls (freq, VGA, AMP, symbol rate) wired to API
    ## Backend API (server.py)
    - GET /api/status — engine status
    - GET /api/config — RF configu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
2026-05-18 HAB Ground Station v0.4 — Multi-page dark dashboard with live data
    ## New Features (this session)
    - SSE spectrum streaming (EventSource, 10Hz, fallback to HTTP polling)
    - Real-time spectrum waterfall (canvas-based, 5-stop color gradient)
    - Device Status Panel (4-column: HackRF, Pipeline, TX, WebSocket)
    - Live telemetry packet generator (1-3s intervals, TLM/EVT/WARN)
    - Animated connection indicator (pulse when data flowing)
    - Clickable mission tiles with visual feedback
    - Dark-themed Telemetry page (StatTiles, Recharts, VideoFeeds, DataStream)
    - Dark-themed FlightMap with glassmorphism telemetry card
    - Scrollable Telemetry page with section dividers
    - Functional RF Config panel (freq, VGA,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
2026-05-20 Add mission control dashboard design specs and Gemini wireframe prompts
2026-05-20 feat: add telemetry panel cards (Tasks 4-5)
    Add MapCard, PositionCard, MotionCard, EnvironmentCard (left panel)
    Add RfLinkCard, PowerCard, AlertsCard, PacketRateCard (right panel)
2026-05-20 feat: add CameraFeed, PacketStream, and MissionControl components (Tasks 6+7)
2026-05-20 feat: build settings page with 5 sub-tabs (device, RF, DVB-S2, pipeline, about)
2026-05-20 feat: finalize mission control dashboard — integration testing and production build
2026-05-20 feat: add REST routes (/health, /api/packets, /api/devices) and WebSocket route with command dispatch
2026-05-20 feat: add main.py FastAPI app wiring and integration tests
2026-05-20 chore: final verification — launch.sh python3 fix and cleanup
2026-05-20 fix: use SoapySDR Python API for /api/devices (not hackrf_info CLI); broadcast status on RUNNING transition
2026-05-20 fix: address code review findings — remove dead WS models, fix spectrum format consistency, clean up unused fields
    - Removed all unused WS envelope Pydantic models (WsPacketMessage, WsStatusMessage,
    WsSpectrumMessage, WsErrorMessage, WsTelemetryMessage, WsEngineStatusMessage,
    CmdStart, CmdStop, CmdConfigure) from models.py — actual WS messages are
    constructed as raw dicts
    - Removed unused ServerConfig instantiation from main.py
    - Simulation spectrum loop now uses ws_manager.broadcast_spectrum() directly,
    matching the real hardware broadcast format via SpectrumFrame
    - Removed unused _uptime_start field from receiver_manager.py
    - Fixed cleanup task tuple to include _simulate_task e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
    [main.py]
2026-06-06 feat: external packet ingestion API + standalone balloon-sim.py
    - POST /api/packet endpoint validates and ingests telemetry packets
    - ReceiverManager.ingest_packet() broadcasts to all WebSocket clients
    - balloon-sim.py: standalone CLI simulator with realistic flight profile
    (ascent → float → descent), standard-atmosphere physics, battery drain,
    configurable speed/rate/profile, and live terminal status
    - ws_manager.py: add __future__ annotations import
2026-06-06 Reorganize repo structure + add balloon telemetry simulator
    Restructured hab/ repository for clarity:
    receiver-server/ → dashboard/server/
    web-dashboard/ → dashboard/web/
    balloon-sim/ → dashboard/sim/ (new — balloon telemetry simulator)
    rf-link/ → rf/
    hab-esp32/ → firmware/
    hab-gui/ → gui/
    pcb/ → hardware/
    Added balloon-sim (dashboard/sim/):
    - sim.py: Standalone terminal app that generates realistic balloon
    telemetry (position, motion, environment, power) and POSTs to
    the receiver server's /api/packet endpoint
    - run.sh: One-click launcher (fast mode, 10x)
    - README.md: Full data format documenta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
    [105mmHeater.dxf, Keepout.dxf, Power_Amplifier.dxf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]
2026-06-06 feat: add SparklineGraph component with line-only rendering and y-axis ticks
2026-06-06 feat: add TelemetryCard with Navigation, Environment, Power&Link, and Attitude sections
2026-06-06 fix: remove duplicate type definitions and dead environment prop
2026-06-23 dashboard: UI cleanup — dark leaflet theme, locate button, sidebar strip, mission time fix
    - MapCard.tsx: Add LocateButton (crosshair icon below zoom) that flyTo's
    balloon position; enable zoomControl; fix map height from h-[35%] to
    h-full so it fills grid cell
    - Sidebar.tsx: Strip to 2 icons (Monitor + Settings), drop Radio/Info/ChevronLeft
    - useHabApi.ts: Mission time now derived from wall clock since first
    telemetry packet (fixes T+00:00:00 stuck state); initial state all zeros
    instead of stale simulated values; initial phase PRE-LAUNCH
    - index.css: Dark theme Leaflet — map bg, attribution bar, zoom controls,
    and locate button all styled to match dashboard surface palette
2026-07-20 feat: SDR pipeline + logging system + RF config defaults + video URL fix
    ## SDR Pipeline
    - sdr_rx_worker.py: GNU Radio flowgraph with HackRF source, dual Freq Xlating FIR,
    DVB-S2 RX chain (gr-dvbs2rx), TS pipe output, JSON-RPC stdin/stdout protocol
    - sdr_manager.py: subprocess lifecycle (start/stop/configure), ffmpeg MJPEG spawn,
    status broadcasting, worker status merging
    - sdr_status.py: WebSocket diagnostic client for live SDR telemetry
    ## DVB-S2 Fixes
    - ISI filter: -1 (accept all) to prevent BBHEADER frame dropping
    - ffmpeg error tolerance: -err_detect ignore_err -ec 0 -fflags +genpts+discardcorrupt
    - TS test file: Big Buck Bunny, 640x360@15fps, 850 kbps muxrate (under 965 kbps limit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
2026-07-22 feat(payload): GPS verified + hardware bringup documentation
    - Add SETUP.md: full Rock 2A peripheral config reference
    - Device tree overlays (I2C0, I2C1, UART0, disable FIQ/PWM)
    - GPIO pin mapping (GPS control, heater, PA, LEDs)
    - udev rules, sudo config, Python deps
    - FIQ debugger saga (root cause of GPS silence)
    - L76K feature audit (EASY, LOCUS, AIC, update rate)
    - Boot sequence and test results
    - Update PLAN.md with actual hardware state:
    - GPS: /dev/ttyS0 (UART0 M0), 8 sats, 3D fix PASS
    - Fuel gauge: MAX17049 verified on I2C bus 1 PASS
    - Sensors: I2C bus 0 float - confirmed broken hardware
    - Pin mapping corrected (UART0 not UART2)
    - Open questions updated
    - Add p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
2026-07-22 feat(packet-radio): GPS packet radio pipeline — TX, bridge, packet format
    - New typed binary frame format (packet_format.py): 38-byte PositionFrame
    with type tag, matching dashboard PositionPacket interface
    - gps_packet_tx.py: GPS→PositionFrame→BPSK via GNU Radio (same chain
    as validated pkt_simple_tx.py baseline)
    - gps_bridge.py: launches pkt_simple_rx.py with --hex-output, parses
    hex payloads, unpacks PositionFrames, POSTs to /api/packet
    - pkt_simple_rx.py: added --hex-output flag for binary payload support
    (backward compatible — ASCII output still default)
    - nmea.py: added HDOP extraction from GGA field 8
    - PLAN.md §11: packet radio architecture documented
    - SETUP.md: GNU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
2026-07-22 snapshot(packet-radio): validated pipeline — 187 packets, 5min continuous
    - gps_packet_tx.py: SoapySDR sink fix (7-arg form for arm64 GNU Radio 3.10)
    - gps_bridge.py: hex-output decode, fix_type mapping, error handling, working-dir fix
    - gitignore: .hermes/ and *.db artifacts
    Verified: Rock 2A TX → HackRF → Mac RX → bridge → dashboard POST (200 OK)
    157 decoded, 187 good RF, 0 dropouts over 311s at 915 MHz BPSK 100ksym/s
2026-07-22 docs: system architecture — topology, data flow, frame format, launch commands, known issues
    Covers Rock 2A TX → HackRF → Mac RX → bridge → dashboard pipeline
    Includes layer diagram, file map, JSON schemas, gotchas, future notes
2026-08-01 chore: reorganize rf/ into dev/ + ground/payload split
2026-08-01 feat(rf-link): composite DVB-S2 video + BPSK telemetry link, soak-validated
    Live E2E link on one HackRF per side (Rock 2A TX, Mac RX):
    - combined_tx.py: composite TX (BPSK telemetry + DVB-S2 video), --video-source
    option (testsrc synthetic), --rrc-delay, pacing fix (no --out-real-time),
    direct chunk->NumPy reads, cached oscillators, FFT convolution
    - combined_rx.py: composite RX, decode queue 1->8, one full-rate
    digital.costas_loop_cc per segment seeded from _fine_fo_estimate,
    129-tap filter, --offset support
    - demod.py: replace _costas_correct scheduler-thrash (~200 GR top_block
    setups/batch) with single costas_loop_cc per segment (2.712s -> 0.0595s)
    - soak/soak_monitor.py: 30-min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
2026-08-01 docs: RF link runbook — validated config, full CLI reference, soak + gotchas
2026-08-01 docs: Rock 2A DVB-S2 encoder throughput ceiling — measurement evidence
2026-08-02 feat(rf-link): auto-respawn the video bridge after client disconnect
    combined_rx.py spawned a one-shot ffmpeg MJPEG bridge fire-and-forget and
    never restarted it: once a browser consumed the single client slot, the
    dashboard CameraFeed went dark until the whole RX was restarted.
    Add a supervisor thread (soak-validated pattern from soak_monitor.py):
    - kill stale ffmpeg bridges on startup (pgrep udp://127.0.0.1:<udp_port>)
    - spawn with retry-once + 14s lsof LISTEN probe (never connect(): a connect
    is the one-shot bridge's client and consumes it)
    - respawn within ~5s whenever the bridge exits (served, crashed, or never
    bound), stop-aware so shutdown still terminates the live bridge
    - prese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
2026-08-02 fix(dashboard): derive video status from the live bridge, not the managed receiver
    CameraFeed only mounted its <img> when linkStatus.video was NOMINAL, and
    that was derived from engineStatus.pipeline.running — the dashboard's own
    receiver manager, which stays idle when the RX is run manually (per the
    runbook). With the manual RX posting /api/packet, telemetry flowed but
    video read OFFLINE forever and the feed never mounted, even with a healthy
    ffmpeg MJPEG bridge listening on :8001.
    Add GET /api/video-status: a non-connecting lsof LISTEN probe of :8001
    (connect() would consume the one-shot bridge's single client slot).
    Frontend polls it every 5s and drives linkStatus.video from the real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
2026-11-02 feat(tx,rx): TX-owned GPS GPIOs, DVB-S2 debug stats, restart scripts
    - combined_tx.py asserts/holds GPS_WAKE (gpiochip1:9) and GPS_RST_N
    (gpiochip1:14) itself, kills stale holders, releases on shutdown;
    new --gps-wake-gpio/--gps-rst-gpio args. No manual gpioset needed.
    - 5s [DVBS2] stats lines on both sides (encoder rate + underflow pads;
    rx fifo rate + drops + child/restarts + bridge state); TX child
    stderr captured to /tmp/tx_{dvbs2,ffmpeg}_stderr.log.
    - scripts/restart_tx.sh (deployed to Rock 2A) and scripts/restart_rx.sh:
    bracket-safe kills of every link process, then a fresh validated start.
    - Runbook: restart-script workflow, debug-line reference, dashboard section,
    dead-~/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
2026-11-02 feat(dashboard): no-fix map filtering + bridge-aware video status
    - Map/trail/marker/pan only plot fix && non-zero coordinates; banner and
    map badge show NO FIX. Packet ingestion, telemetry cards and DB storage
    unchanged (zeros still logged).
    - /api/video-status reports up when the bridge holds ANY socket on :8001
    (LISTEN or ESTABLISHED). The old LISTEN-only probe flipped OFFLINE while
    a client was streaming, unmounting the feed every poll cycle.
2026-11-02 chore(scripts): restart_rx.sh also brings up the dashboard on :8000
    One script now covers the whole ground station: RX + DVB-S2 child +
    hackrf_transfer + bridge, then the dashboard if :8000 is free.
